CursedHardware/HLW8012/软件设计/电能计量产品校准.pdf

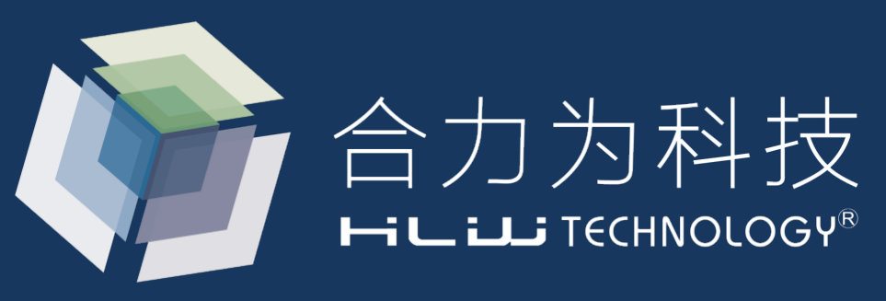
[picture p3: figure]

# 电能计量模块校准办法

2020年9月3日
Thursday

www.hiliwi.com

# 主要内容

# 一、电能计量模块为何要校准？ 二、校准原理 三、校准办法

1

# - 电能计量模块各部分线性误差

# 一、电能计量模块为何要校准？

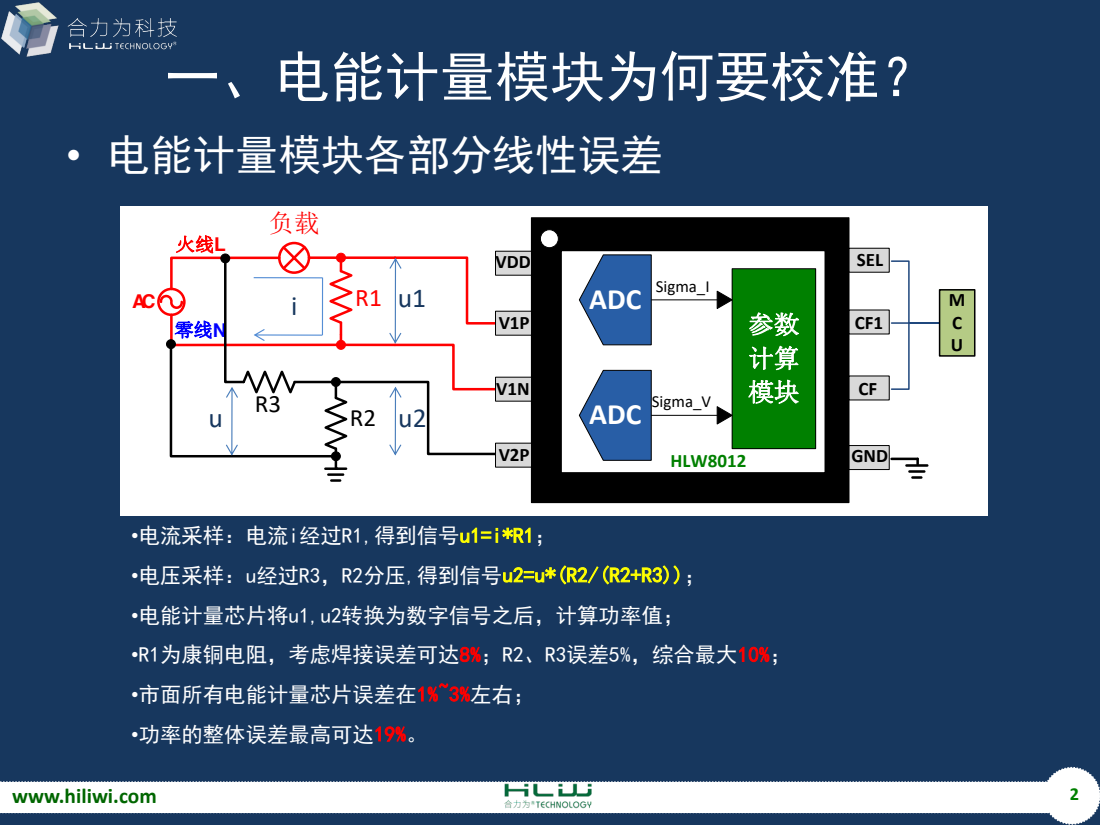
[picture p4: page 3]
火线L; 零线N; •电流采样：电流i经过R1,得到信号u1=i*R1；; •电压采样：u经过R3，R2分压,得到信号u2=u*(R2/(R2+R3))；; •电能计量芯片将u1,u2转换为数字信号之后，计算功率值；; •R1为康铜电阻，考虑焊接误差可达8%；R2、R3误差5%，综合最大10%；; •市面所有电能计量芯片误差在1%~3%左右；; •功率的整体误差最高可达19%。; Sigma_I; Sigma_V; ADC; GND; VDD; SEL; HLW8012

# - 校准原理

# 二、校准原理

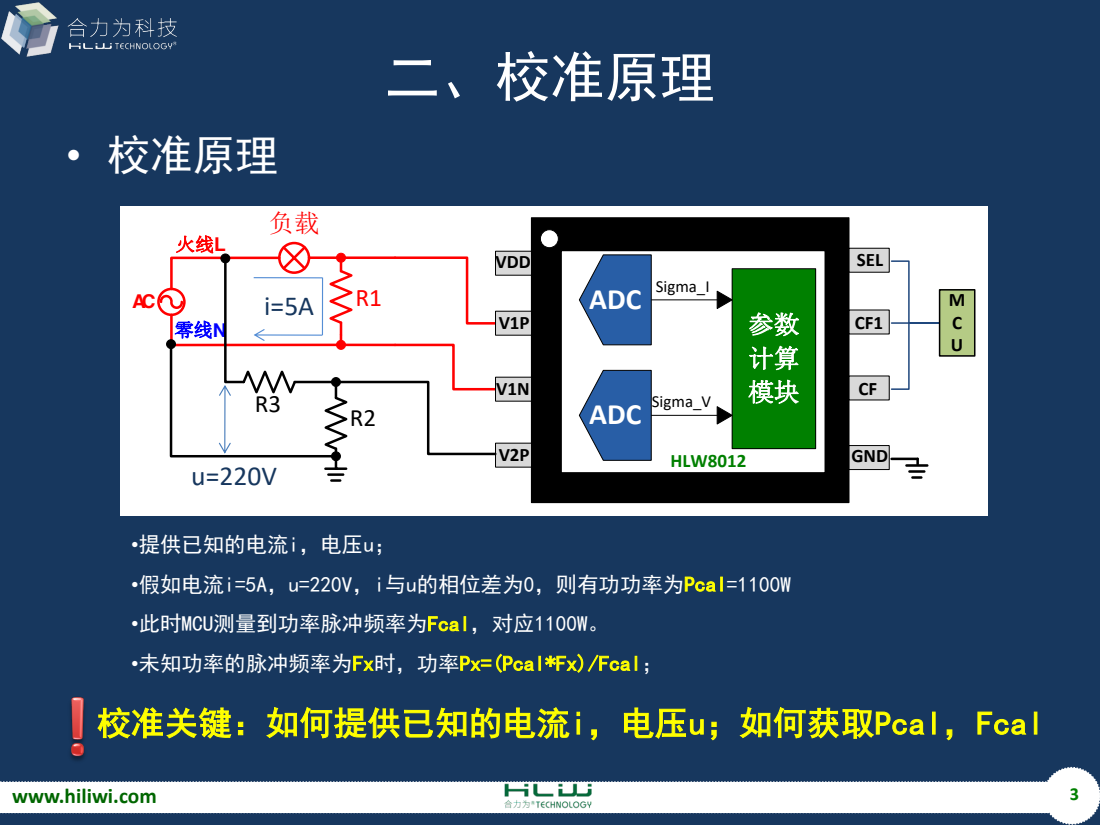
[picture p5: page 4]
火线L; 零线N; Sigma_I; Sigma_V; ADC; GND; VDD; SEL; HLW8012; •提供已知的电流i，电压u；; •假如电流i=5A，u=220V，i与u的相位差为0，则有功功率为Pcal=1100W; •此时MCU测量到功率脉冲频率为Fcal，对应1100W。

•未知功率的脉冲频率为Fx时，功率Px=(Pcal*Fx)/Fcal；
校准关键：如何提供已知的电流i，电压u；如何获取Pcal，Fcal

# 三、校准办法

# - 校准办法1：稳压电源+定值负载

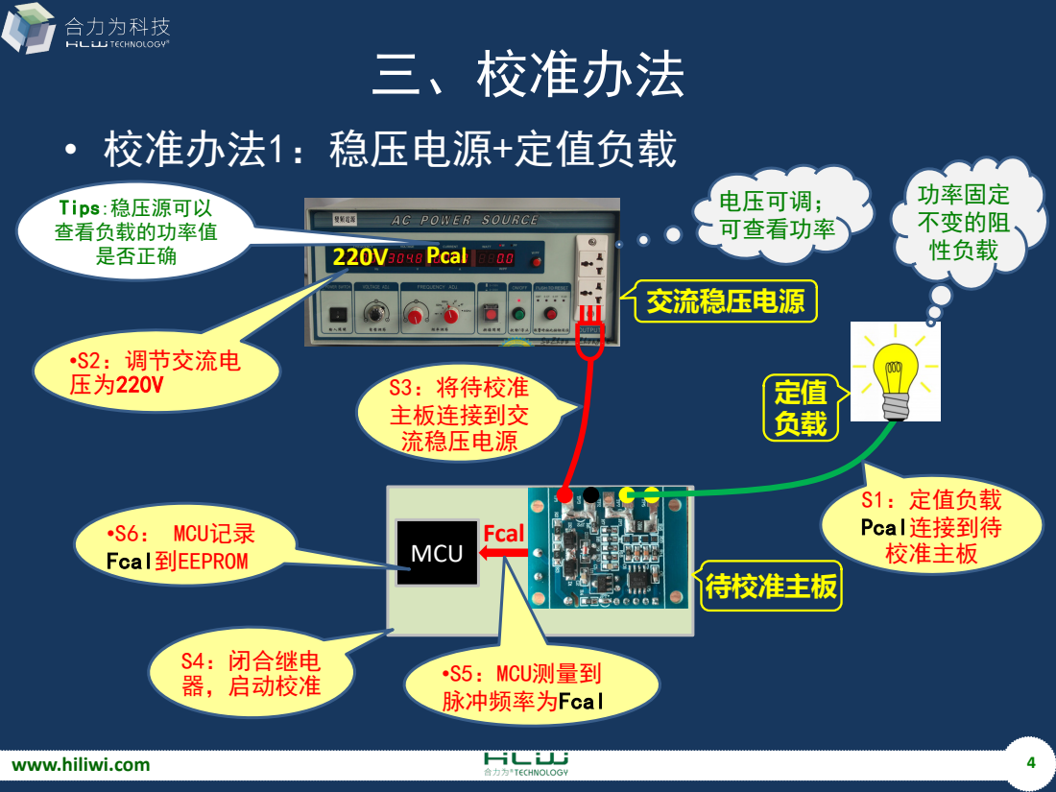
[picture p6: page 5]
交流稳压电源; 220V Pcal; MCU; 待校准主板; Fcal; S1：定值负载 Pcal连接到待 校准主板; •S2：调节交流电; S3：将待校准; 主板连接到交 流稳压电源; S4：闭合继电; 器，启动校准; •S5：MCU测量到; 脉冲频率为Fcal; •S6： MCU记录 Fcal到EEPROM; Tips:稳压源可以 查看负载的功率值 是否正确; 功率固定 不变的阻 性负载; 电压可调； 可查看功率

# 三、校准办法

5

### 1、交流稳压电源

•可以输出稳压220V电源
•可查看当前功率值
•根据需求选择相应的最大额定功率值

### 2、定值负载（纯阻性负载）

•若精度要求低，可选用白炽灯炮
•若精度要求稍高，可选用单管电阻器
•若精度要求高，可选用负载箱；（长时间工作功率均稳定）

### 3、此校准办法适用于

•产品本身不带负载，如WIFI智能插座等，待校准物体可以是成品 •产品本身若带负载，待校准物体需是主板，使用定值负载替换本身负载

# - 校准办法1：注意事项

# 三、校准办法

# - 校准实例1：WIFI智能插座

•Step1：连接排插到交流稳压源之后，打开电源
•Step2：调节交流电压为220V

•Step3：将插座插到排插上

定值
负载

定值
负载

定值
负载

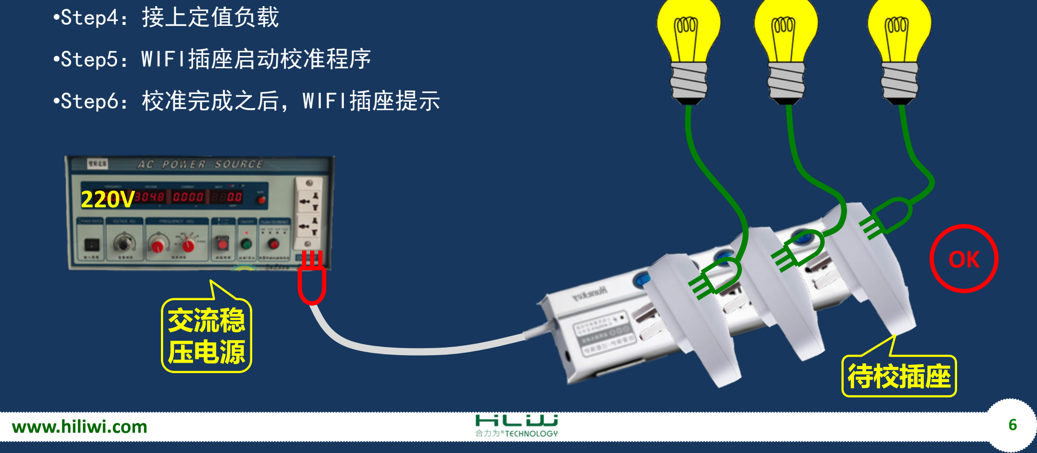
[picture p7: figure]
交流稳 压电源; •Step4：接上定值负载; •Step5：WIFI插座启动校准程序; •Step6：校准完成之后，WIFI插座提示; 待校插座

# 三、校准办法

# - 校准办法2：专用校准负载

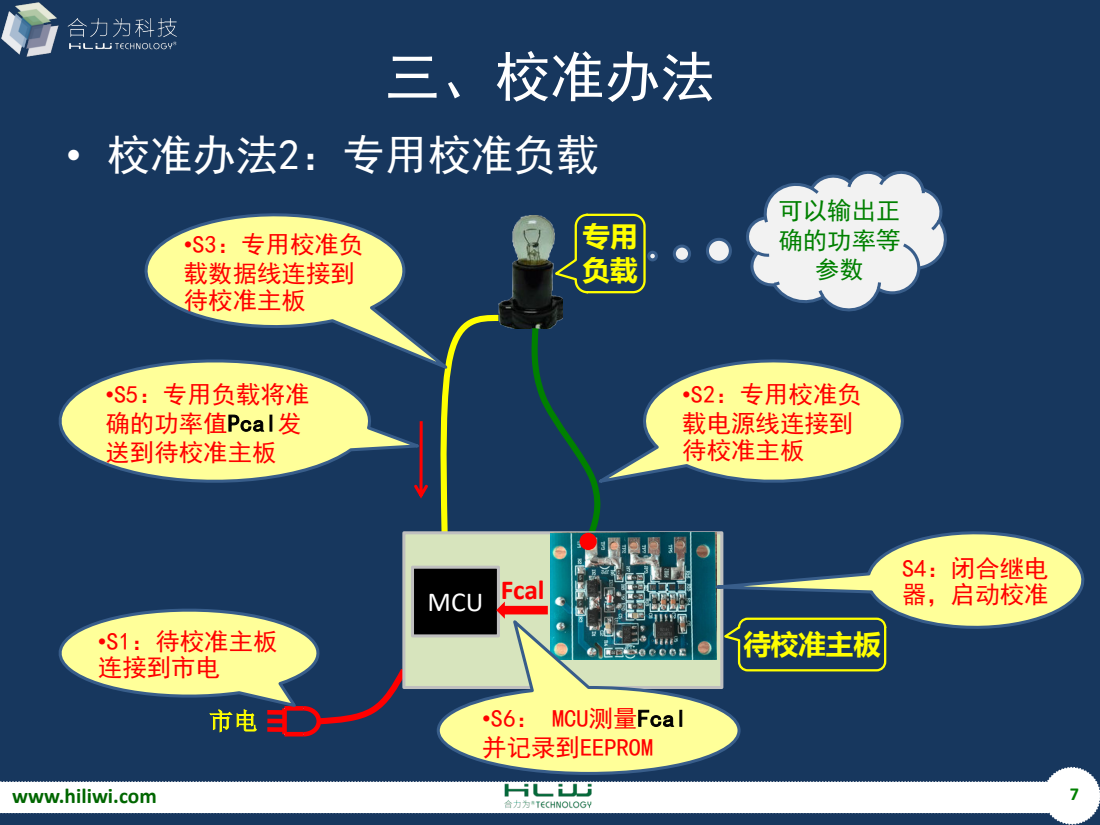
[picture p8: page 8]
•S1：待校准主板 连接到市电; •S2：专用校准负 载电源线连接到 待校准主板; •S3：专用校准负 载数据线连接到 待校准主板; 待校准主板; MCU; Fcal; S4：闭合继电 器，启动校准; •S5：专用负载将准 确的功率值Pcal发 送到待校准主板; •S6： MCU测量Fcal 并记录到EEPROM; 可以输出正 确的功率等 参数

# 三、校准办法

8

### 1、专用校准负载

•可以测量正确的电压、电流、有功功率等参数
•通过通讯接口向待校准物体发送上述参数
•通讯接口有：SPI/I2C/UART/USB等
•专用校准负载作为一个负载连接到待校准物体
•准确度的误差可以达到<1%

### 2、此校准办法适用于

•产品本身不带负载，如WIFI智能插座等，待校准物体可以是成品 •产品本身若带负载，待校准物体需是主板，此专用负载替换本身负载

# - 校准办法2：注意事项

# 此专用校准负载正在研发中！

# 三、校准办法

# - 校准实例2：WIFI智能插座

•Step1：连接排插到市电
•Step2：将插座插到排插上

专用
负载

专用
负载

专用
负载

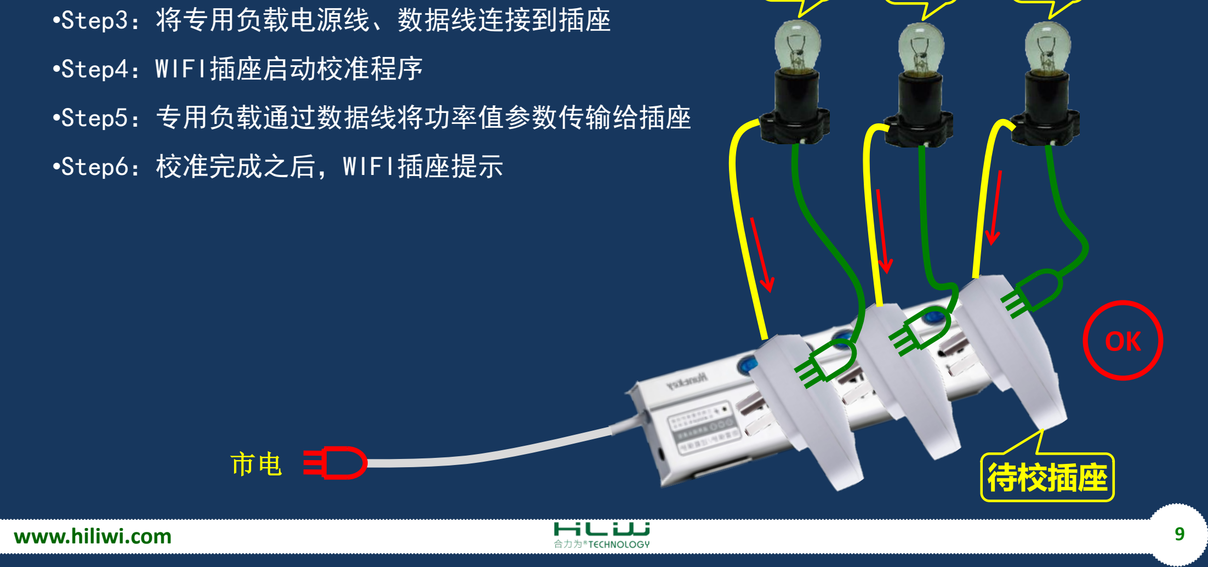
[picture p9: figure]
•Step3：将专用负载电源线、数据线连接到插座; •Step4：WIFI插座启动校准程序; •Step5：专用负载通过数据线将功率值参数传输给插座; •Step6：校准完成之后，WIFI插座提示; 待校插座
