CursedHardware/HLW8012/测量出现误差的原因.pdf

# 测量值出现误差的原因

# 一、 测量值出现误差或测量值不准确，有可能是以下两个因素造成

的：

1.1 | 软件的测量方法引起的误差
1.2 | 校准引起的误差

# 二、 误差分析

# 2.1 软件的测量方法引起的误差

| 考虑到测量精度和测量时间的关系，我们采用分段测量的方法。 需要使用到的硬件资源如下: 1、1ms 定时器 2、I/O:3 个，其中两个外部中断口 软件测量方法: 1、 被测脉冲周期大于等于 100ms，采用测量单个周期的方法，测量 误差 = 1ms/T,因为 T>100ms,所以测量误差小于 1%; 2、 被测脉冲周期小于 100ms 时，我们采用定时测量>1S 时间方法; 或采用测量 N 次完整周期时间，测量时间大于 1S（或 600ms，具 体时间视实际应用条件）的方式; 3、 计算公式如下:
参数说明: | :单位时间内出现的脉冲个数
| :被测信号脉冲周期

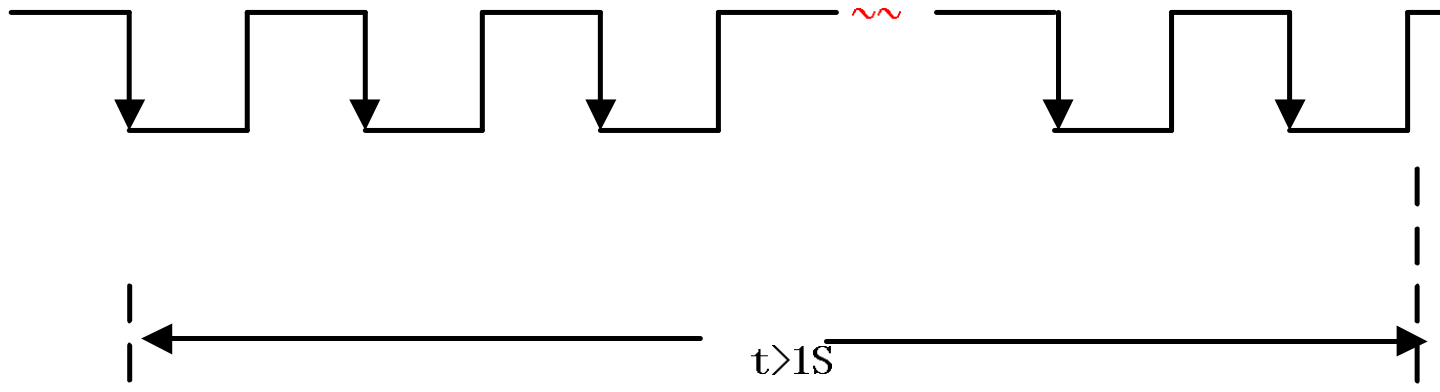
[picture p10: figure]

# 误差产生的原因：

# 在 3600W 时，功率的输出频率约是 870Hz，周期是 T = 1/870 = 1.14ms。

# 如果采用的是 1m S 定时器，不采用平均值的算法，则有 3600W*(0.14/1.14) = 442W 的误差，这样引起的误差就会很大。 如果测量方法中未采用到方 2，因此在测量大功率值时，会有比较大的 跳动，测量值不准确。

# 2.2 校准引起的误差

# 下表是 HM8012 采用不同负载进行校正后的数据: 1) 采用 1000W 负载进行校正后的数据

1 00 0 W校正
标准信号 | 测量值
设置功率 | 仪器输出功率(MAX)仪器输出功率(MIN) 电压 | | | 电流 | 功率(MAX) 功率(MIN)误差 | | | 电压(MAX)电压(MIN)误差 | | | 电流(MAX)电流(MIN) 误差
0 | 0 | 0.00 | 220.1 | 0.0000 | 0.0 | 0.0 | | 221.1 | 220.0 | 0.20% | 0.016 | 0.016
0.2 | 0.17 | 0.17 | 220.1 | 0.0008 | 0.2 | 0.1 | -11.76% | 221.1 | 220.0 | 0.20% | 0.016 | 0.016
0.3 | 0.33 | 0.33 | 220.1 | 0.0015 | 0.3 | 0.3 | -9.09% | 221.1 | 220.0 | 0.20% | 0.016 | 0.016
0.5 | 0.44 | 0.44 | 220.1 | 0.0020 | 0.4 | 0.4 | -9.09% | 221.1 | 220.0 | 0.20% | 0.016 | 0.016
1 | 1.10 | 1.10 | 220.1 | 0.0050 | 1.1 | 1.0 | -4.55% | 221.1 | 220.0 | 0.20% | 0.016 | 0.016
2 | 1.99 | 1.99 | 220.08 | 0.0090 | 2.0 | 1.9 | -2.01% | 221.1 | 220.0 | 0.21% | 0.016 | 0.016
5 | 5.06 | 5.06 | 220.1 | 0.0230 | 5.0 | 5.0 | -1.19% | 221.1 | 220.0 | 0.20% | 0.024 | 0.024 | 4.35%
10 | 9.99 | 9.89 | 219.95 | 0.0450 | 9.9 | 9.8 | -0.91% | 221.1 | 220.0 | 0.27% | 0.046 | 0.046 | 2.22%
50 | 49.96 | 49.92 | 219.96 | 0.2270 | 49.9 | 49.8 | -0.18% | 221.1 | 220.0 | 0.27% | 0.226 | 0.226 | -0.44%
100 | 100.15 | 100.09 | 220.1 | 0.4548 | 100.0 | 99.9 | -0.17% | 221.1 | 220.0 | 0.20% | 0.454 | 0.453 | -0.29%
250 | 250.17 | 250.03 | 220.2 | 1.1361 | 250.1 | 249.8 | -0.06% | 221.1 | 220.0 | 0.16% | 1.136 | 1.134 | -0.10%
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

1、采用的校准源是非纯组性负载，校准源的不准确造成的误差;

# 2、采用大功率负载设备校准，大功率负载设备本身的功率不是很稳定，在

一个范围幅度内跳动;

# 3、负载设备从上电到功率达到稳定时，需要一个时间过程，校准时未待负

载设备稳定就进行校准;
4、大功率负载上电后，容易发烫，功率值也会随之发生变化;

# 5、校准程序未采用取平均值的方式，如软件测量方法中的方式 2，测量多次

周期取平均值;

建议：

# 1、 从图表中可以看出，小功率负载的校准线性在千分之三以内，建议采用

小负载进行校准;

# 2、 软件上面建议采取测量取平均值的方式，以减小误差。
