CursedHardware/HLW8012/HLW8012DEMO/schematic.pdf

采样方式：隔离采样（互感器） | +5V I+

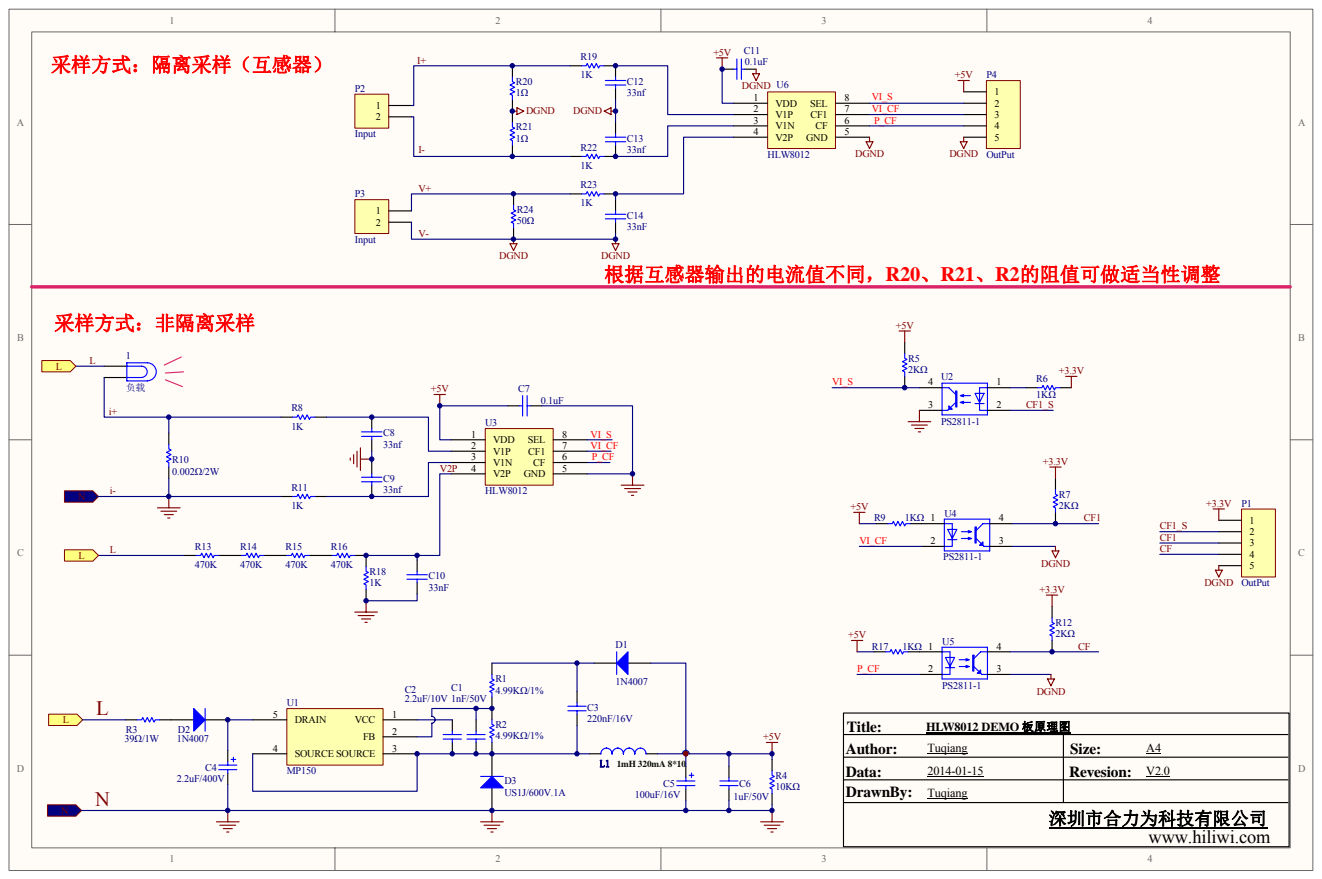
[picture p18: page 1]

1K R20 1Ω DGND DGND R21 1Ω R22 | C12 33nf C13 33nf
