CursedHardware/HLW8012/硬件设计/HLW8012电路应用参考设计(非隔离采样).pdf

N

L | HLW8012采样电路:非隔离采样方式

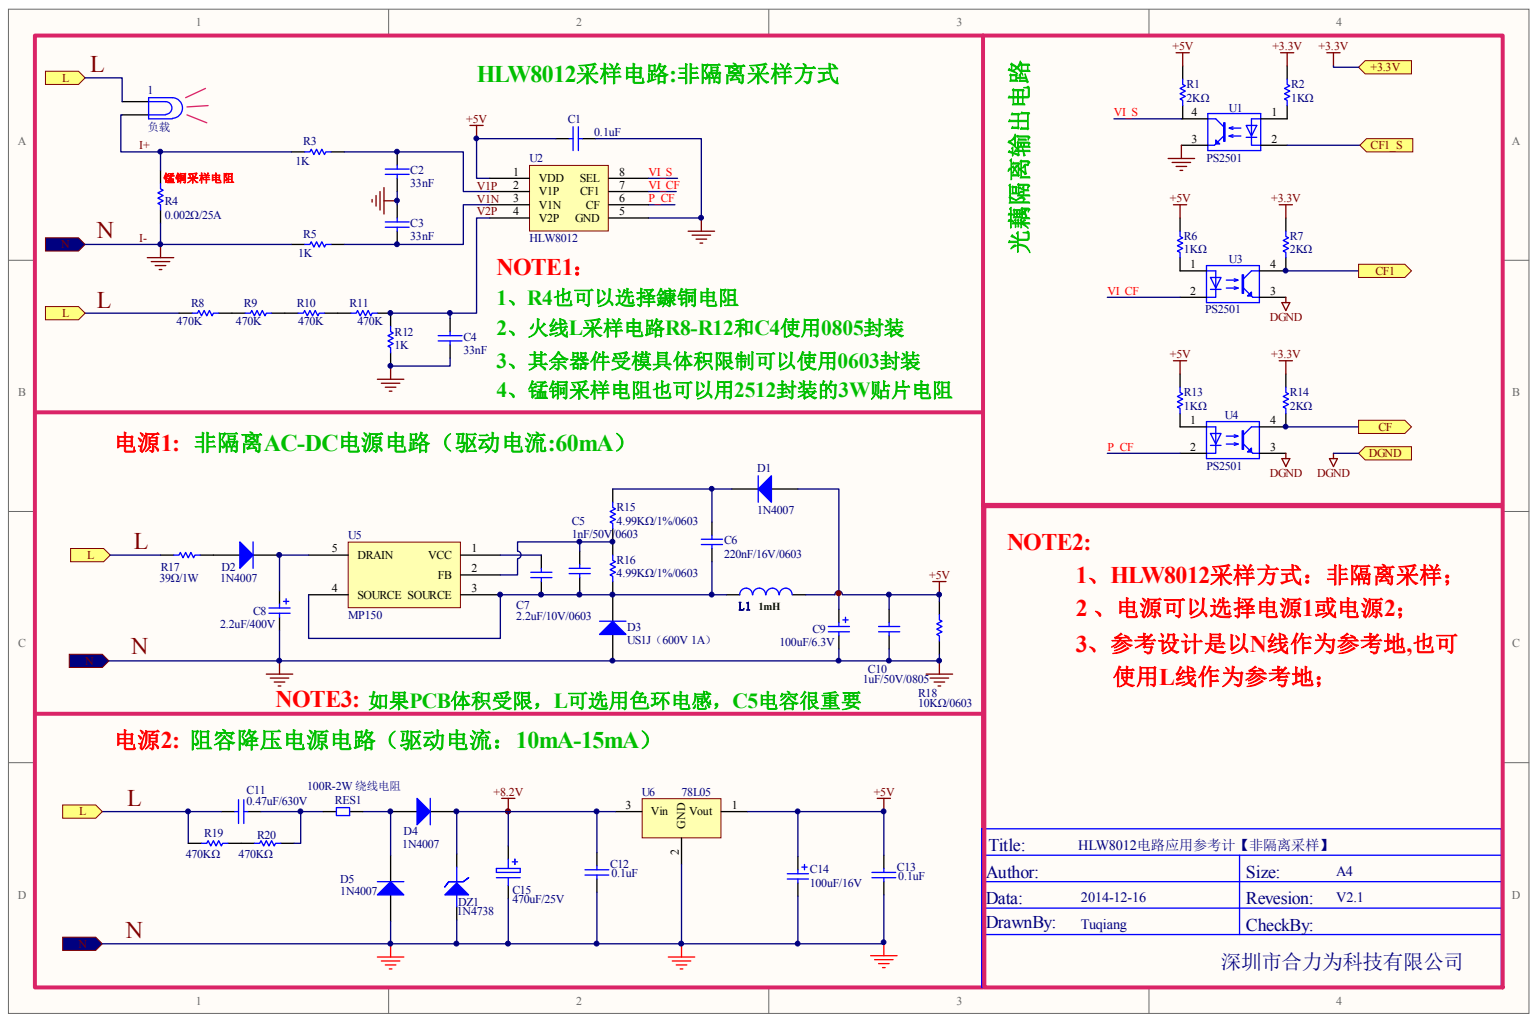
[picture p19: page 1]

电源1: 非隔离AC-DC电源电路（驱动电流:60mA） | NOTE3: 如果PCB体积受限，L可选用色环电感，C5电容很重要 | | | D1 1uF/50V/0805 R18

电源2: 阻容降压电源电路（驱动电流：10mA-15mA） 100R-2W 绕线电阻 C11 +8.2V | | U6 | 78L05 | +5V
