CursedHardware/HLW8012/硬件设计/HLW8012电路应用参考设计(隔离采样).pdf

# HLW8012采样电路:隔离采样方式

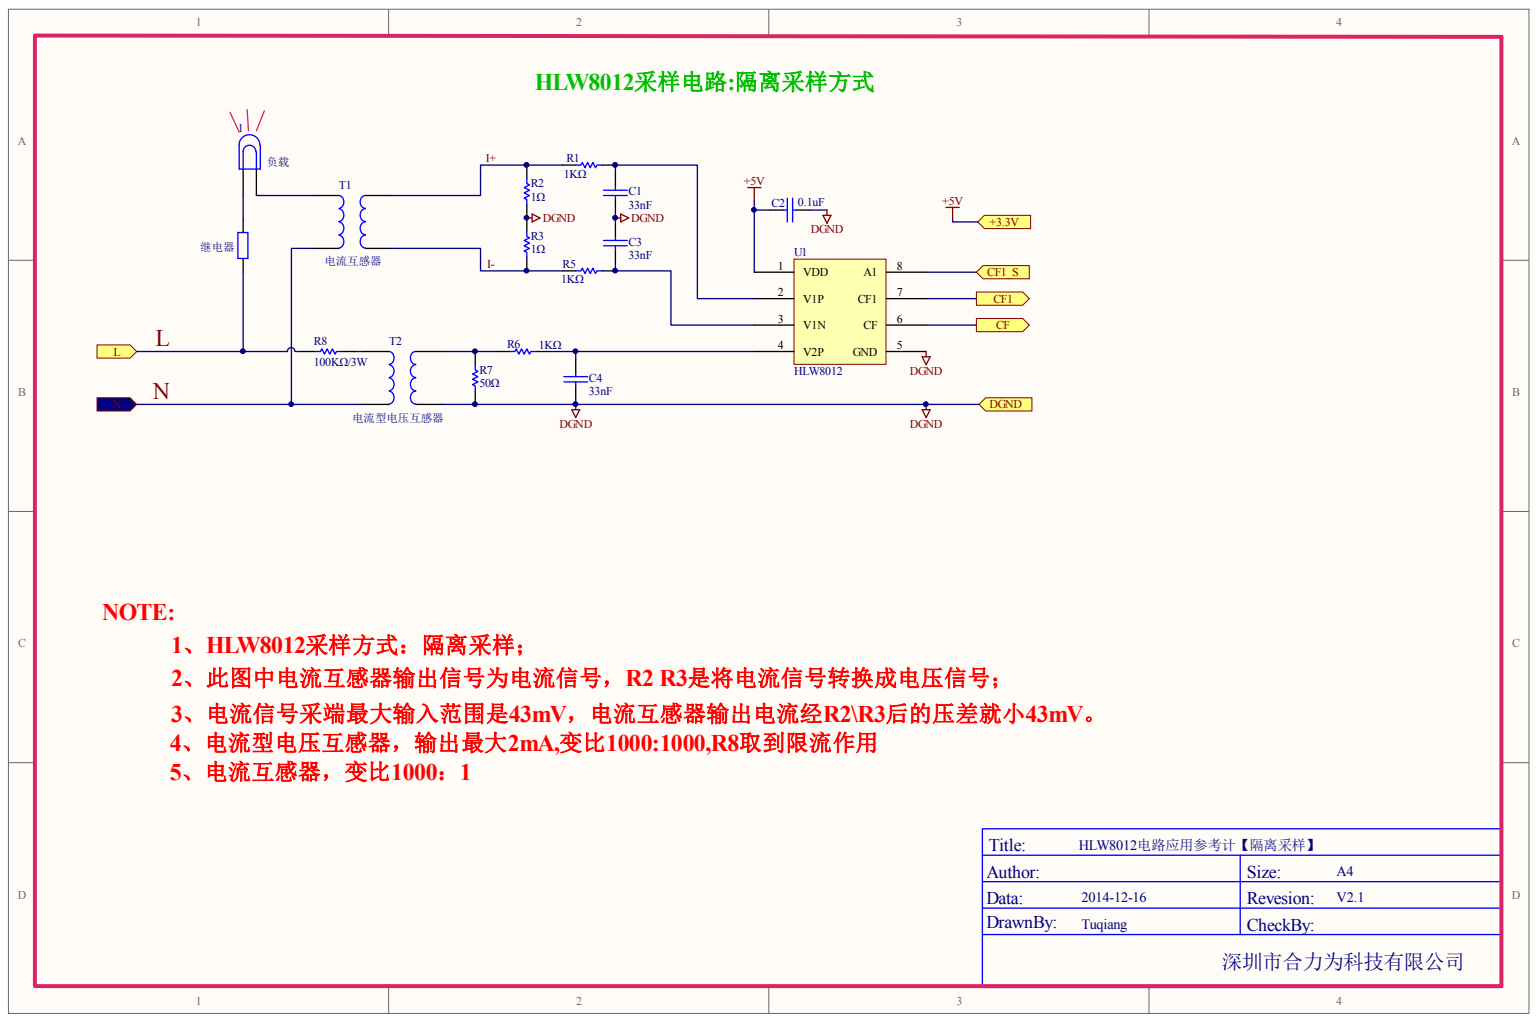
[picture p20: page 1]
