CursedHardware/HLW8012/(list of files, drawings)

Other design files:
HLW8012DEMO/PCB-HLW8012DEMO-V22.pcb
